prism560/TacLinkArm/sketches/fsr_servo/README.md

# fsr_servo
- 배선: FSR 분압(위쪽 Nano 5V) → A0, SG90 신호 → D9, 서보 전원 AA×4(약 6V), GND 공통
- 동작: `map(v, 20, 988, 0, 180)` + `constrain`, 3° 미만 변화는 무시(떨림 방지), 115200 baud
- 결과(2026-11-02): 누르는 정도에 따라 0→180° 연속 이동 — 분압 위쪽은 반드시 Nano 5V(6V에 연결하면 A0 과전압)
