prism560/TacLinkArm/notes/mcu_basics.md

# MCU 작동 원리 (클럭 · GPIO · ADC)

- 날짜: 2026-10-12 (S1 3주차)
- 보드: Arduino Nano (ATmega328P)

## 오늘 한 것
- Arduino 공식 문서 2개를 읽고 클럭·GPIO·ADC를 내 말로 정리했다.
  - [Digital Pins](https://docs.arduino.cc/learn/microcontrollers/digital-pins/)
  - [Analog Read Serial](https://docs.arduino.cc/tutorials/uno-rev3/AnalogReadSerial/)
  - 클럭 사양: [Arduino Nano](https://docs.arduino.cc/hardware/nano/) Tech Specs

## 클럭: 16MHz
Nano 보드에는 16MHz 클럭 소스가 있다. MCU는 1초에 1600만 번 뛰는 박자에 맞춰 동작하고, 대부분의 명령은 1~2박자 만에 처리된다. 한 박자는 62.5ns이다.
이 박자가 `millis()`·PWM·ADC 같은 모든 시간의 기준이므로, 코드 한 줄이 걸리는 시간과 센서를 1초에 몇 번 읽을 수 있는지(샘플링 속도)의 상한을 예측할 수 있다.

## GPIO: INPUT, OUTPUT, INPUT_PULLUP
GPIO는 general purpose input/output, 즉 범용 입출력을 뜻한다.
INPUT은 핀의 전압을 읽기만 하며, 아무것도 연결하지 않으면 HIGH와 LOW를 오간다. 이것을 플로팅이라 한다.
INPUT_PULLUP은 플로팅을 막기 위해 ATmega 내부 저항(20~50kΩ)으로 핀을 5V 쪽에 붙잡아 둔다. 그래서 스위치를 핀과 GND 사이에 연결하면 평소에는 HIGH, 누르면 LOW가 된다.
OUTPUT은 저임피던스 상태이다. ATmega 핀의 절대 최대 정격은 40mA이므로(실제로는 20mA 이하로 사용), 출력에 필요한 전류에 맞게 직렬 저항을 골라야 한다.

## ADC: 10비트, 0~1023
아두이노 안에는 ADC(Analog-to-Digital Converter)라는 회로가 있다. ADC는 0~5V의 전압을 0~1023(2^10 − 1)의 숫자로 바꾼다.
`analogRead()`는 핀 전압(0~5V)에 비례하는 값을 0~1023 사이의 `int`로 돌려준다. 예를 들어 2V를 읽으면 409를 돌려준다.
한 단계의 크기는 5V / 1024 ≈ 4.9mV이다.

## 아직 모르는 것
- 풀업으로 핀을 5V로 유지하는 원리를 회로이론에서 배운 것 같은데 기억이 잘 안 난다. 회로를 직접 그리고, 계산하고, 설명할 수 있으면 좋겠다.
- (코치 제안) 고임피던스·저임피던스가 정확히 무슨 뜻인지, 왜 입력은 고임피던스이고 출력은 저임피던스여야 하는지.

## Tinkercad 실습 (2026-10-13)
Arduino Uno로 회로 3개를 시뮬레이션했다. 코드는 직접 입력했다.
 
### 1) LED Blink
13번 → 220Ω 저항 → LED 애노드(+), LED 캐소드(−) → GND. `LED_BUILTIN`이 13번이라 보드 LED와 외부 LED가 함께 1초 간격으로 깜빡인다.

```cpp
void setup() {
  pinMode(LED_BUILTIN, OUTPUT);
}
 
void loop() {
  digitalWrite(LED_BUILTIN, HIGH);
  delay(1000);
  digitalWrite(LED_BUILTIN, LOW);
  delay(1000);
}
```
 
### 2) 버튼(INPUT_PULLUP) → LED
버튼을 11번과 GND 사이에 연결했다. 평소에는 내부 풀업 때문에 HIGH(1), 누르면 LOW(0)가 되고 그때 3번의 LED를 켠다. LED 직렬 저항은 캐소드 쪽에 두었다(직렬이면 위치는 상관없다).

```cpp
void setup() {
  Serial.begin(9600);
  pinMode(11, INPUT_PULLUP);
  pinMode(3, OUTPUT);
}
 
void loop() {
  int sensorVal = digitalRead(11);
  Serial.println(sensorVal);
 
  if (sensorVal == LOW) {
    digitalWrite(3, HIGH);
  } else {
    digitalWrite(3, LOW);
  }
  delay(100);
}
```
 
### 3) PWM 밝기 조절
같은 회로에서 `digitalWrite` 대신 `analogWrite`를 썼다. 3번은 PWM 핀(~)이다. 누르면 127(약 50%), 떼면 255(100%)로 밝기가 두 단계로 바뀐다.
 
```cpp
void setup() {
  Serial.begin(9600);
  pinMode(11, INPUT_PULLUP);
  pinMode(3, OUTPUT);
}
 
void loop() {
  int sensorVal = digitalRead(11);
  Serial.println(sensorVal);
 
  if (sensorVal == LOW) {
    analogWrite(3, 127);
  } else {
    analogWrite(3, 255);
  }
  delay(100);
}
```
 
### 실습에서 알게 된 것
- 버튼 입력에는 PWM 핀(11번)보다 2·4·7 같은 일반 핀을 쓰는 것이 좋다. PWM 핀은 출력용으로 아껴 둔다.
## PWM: analogWrite는 0~255
analogRead와 analogWrite는 서로 다른 하드웨어를 사용한다. 각각 10비트 ADC와 8비트 타이머 카운터를 사용한다. 추가로, analogWrite는 0V 또는 5V를 출력하는데 켜져 있는 시간의 비율(duty)만 달리 하여 단계를 조정한다. 이때 duty는 값/255, 평균 전압은 5V*값/255 계산한다.
 
정리하면, 해상도를 높이기 위해 단계를 늘려야 하는데 그러면 타이머 카운터의 비트수를 올려야하고, 그때 1초당 바퀴수가 줄어들며 주파수가 떨어진다. 
따라서 8비트 PWM 타이머 카운터는 해상도와 주파수 사이의 절충이다.

### 왜 8비트인가: 숫자로 (10-14)
- 타이머 카운터는 4µs마다 1씩 올라간다. 8비트면 0~255 한 바퀴가 256박자 = 1024µs ≈ 1ms이므로 1초에 약 1,000바퀴(약 1kHz)다. 10비트였다면 1024박자 ≈ 4ms, 1초에 약 250바퀴(약 250Hz)다.
- (교정) 4µs는 16MHz 클럭을 64로 나눈(분주) 값이다. Arduino가 64를 고른 이유는 Timer0이 `millis()`도 맡기 때문이다(한 바퀴 ≈ 1ms).
- (교정) 실제 주파수: 5·6번 약 980Hz, 3·9·10·11번 약 490Hz.

## 아직 모르는 것 (10-13 추가)
- 타이머 카운터의 비트 수를 늘리면 왜 PWM 주파수가 낮아지는지(해상도와 주파수의 트레이드오프). 코치에게 다시 설명을 듣기로 함. (10-14 해결)

## FSR 분압 (Tinkercad, 2026-10-19)
회로: 5V → FSR → A0 → 10kΩ → GND
- V(A0) = R / (R + FSR) × 5V. 누르면 FSR 저항이 내려가고 V(A0)가 올라간다.
- 풀업도 같은 분압이다: 위가 풀업 저항 R, 아래가 스위치 r. r = 0(누름)이면 0V, r = ∞(뗌)이면 5V.
- 측정: v 최소 0, 최대 466(약 2.28V). 시뮬의 FSR은 최대 힘에서도 약 12kΩ이라 1023까지 가지 않는다(코치 계산).
- 다음: 실물 FSR 402로 최소·최대를 다시 재고, `map()`의 입력 범위를 그 값으로 정한다. → 실물 결과는 [FSR→LED](fsr_led.md)
