prism560/TacLinkArm/docs/proposal.md

# TacLinkArm V1 기획서

> 상태: 목차와 요약 초안 (2026-10-05). 본문은 S1 12주차(12-14 \~ 12-20)에 완성한다.

## 1\. 배경·동기

연구 분야를 탐색하다가 촉각 데이터에 관심을 갖게 되었다. 사람이 생각하는 대로 로봇이 움직이고, 로봇이 느낀 것을 사람이 다시 느낄 수 있는 장치가 있다면 활용 범위가 매우 넓다고 판단했다.

## 2\. 목표와 성공 기준

* **목표**: 전완부 근전도(sEMG) 신호를 읽어 그리퍼를 움직이고, 그리퍼가 물체에 닿거나 물체를 잡았을 때 사용자의 손에 진동이 울리는 폐루프를 만든다.
* **성공 기준**: 완성도가 아니라 폐루프의 성립이다. "근육 신호 → 그리퍼 구동 → 파지 압력 감지 → 진동 피드백"이 처음부터 끝까지 끊김 없이 동작하면 성공이다.

## 3\. 시스템 구성 (3개 분야)

|분야|V1에서 하는 일|주요 부품|
|-|-|-|
|제어 입력|주먹 쥐기와 손 펴기 두 동작을 2채널 sEMG로 읽고, 근수축 세기에 비례하는 값으로 구분한다(RMS 엔벨로프·임계값 기반).|MyoWare 2.0 ×2|
|로봇팔·그리퍼|오픈소스 STL 기반의 전동식 2지(2-finger) 그리퍼를 출력·조립한다. 주먹을 쥐면 책상 위 물체를 안정적으로 잡고, 손을 펴면 놓는다. 압력(FSR)과 모터 전류(INA219)를 함께 보고 파지력을 조절한다.|서보, FSR 402, INA219|
|촉각 피드백|그리퍼가 감지한 파지 압력을 정해진 범위의 진동 세기로 바꿔 사용자의 손에 전달한다.|DRV2605L, LRA|

## 4\. V1 범위와 제외 항목

V1은 위 3개 분야의 최소 폐루프만 다룬다. 커스텀 PCB, 고전압 회로, 딥러닝 기반 신호 디코딩은 쓰지 않는다. 아래 항목은 의도적으로 V2·V3로 미룬다.

### V2

* 표면 근전도(sEMG) 및 햅틱 폐루프 XR 컨트롤러
* 다채널 플렉서블 인공 피부(E-Skin) 압력 센싱 및 로깅 모듈
* 블라인드 촉각 인식 기반 물체 물성 판별 그리퍼 (Project: Hand Without Eyes)
* 비전 기반 이미지/텍스트-촉각(Image/Text-to-Tactile) 신호 변환 및 햅틱 렌더러
* 초저지연 무선 텔레-햅틱(Tele-Haptics) 웨어러블 피드백 밴드
* 표면 근전도(sEMG) 기반 손목 제스처 무선 컨트롤러
* 다채널 sEMG 기반 연속 손동작 추정 및 로봇/드론 조작기
* 오디오/비디오 신호 기반 실시간 햅틱 렌더러 (X-to-Tactile Controller)

### V3

* 미디어파이프 손 포즈 연동 5자유도 섀도우 로봇 핸드 텔레오퍼레이션
* Tactile Property Determination Device
* 정전기 표면 마찰력(Electroadhesion) 변조 터치 패드
* 형상 변형(Shape-Changing) 및 2.5D 촉각 렌더링 디스플레이

### 장기 목표 (V2·V3 이후)

최종 목표는 다음 네 가지를 구축하는 것이다.

* 사람의 손가락 단위 움직임까지 감지하는 신경공학적 추적
* 사람의 손가락 움직임을 모방하는 로봇 손과 팔
* 사람의 촉각 인지를 모방한 로봇 그리퍼 센서
* 실제로 만지는 듯한 느낌을 전달하는 햅틱 장치 또는 신경공학적 방법론

## 5\. 시즌별 일정

V1은 15개월, 5개 시즌으로 진행한다.

|시즌|기간|목표|
|-|-|-|
|S1|1\~3개월차|연구 기획 및 이론·하드웨어 뼈대 구축|
|S2|4\~6개월차|제어 입력계통 및 구동부 구현|
|S3|7\~9개월차|센서 융합·적응형 파지력 제어 및 로봇 아키텍처 도입|
|S4|10\~12개월차|햅틱 폐루프 구현 및 AI 기반 신호처리 연동|
|S5|13\~15개월차|최적화, 시연 및 대학원용 포트폴리오 문서화|

S4의 AI 모델은 V1의 임계값 기반 제어와 비교하기 위한 벤치마크이며, V1 폐루프의 제어는 임계값·RMS 기반으로 유지한다.

## 6\. 부품·예산

* 부품 목록: [BoM.md](../BoM.md)
* 예산: V1 전체 시즌 합계 1,000만 원 이하

## 7\. 위험 요소와 대응

초안이며, 진행하면서 보완한다.

|위험 요소|대응|
|-|-|
|부품 배송 지연·초기 불량|납기가 긴 부품부터 주문하고, 핵심 부품은 예비 수량을 두며, 도착 즉시 검수한다.|
|sEMG 신호 품질(전극 위치, 땀, 움직임 잡음)|1채널부터 시작하고, 전극 위치를 기록하며, RMS 엔벨로프와 임계값을 사용자에 맞게 보정한다.|
|인체 부착 센서의 전기 안전|MyoWare는 배터리 등 절연된 전원으로 구동하고 안전 수칙을 먼저 확인한다.|
|서보 구동 시 전원 부족·잡음|서보 전원을 별도 배터리로 분리하고 접지를 공통으로 연결한다.|
|납땜·3D 프린팅 경험 부족|검증된 오픈소스 모듈과 STL을 조합하고, 학교 3D 프린팅 자원을 활용한다.|
|단독 개발에 따른 일정 지연|주당 작업량 상한과 완충 주를 두고, 폐루프와 무관한 항목부터 뒤로 미룬다.|

## 8\. 기록·공개 방식

* GitHub 저장소에 빌드로그를 공개한다(`notes/` 폴더, 진행 중).
* 추후 블로그와 포트폴리오 사이트를 구축한다.
