prism560/TacLinkArm/docs/img/2026-11-04/KakaoTalk_20261104_235307183_01.jpg

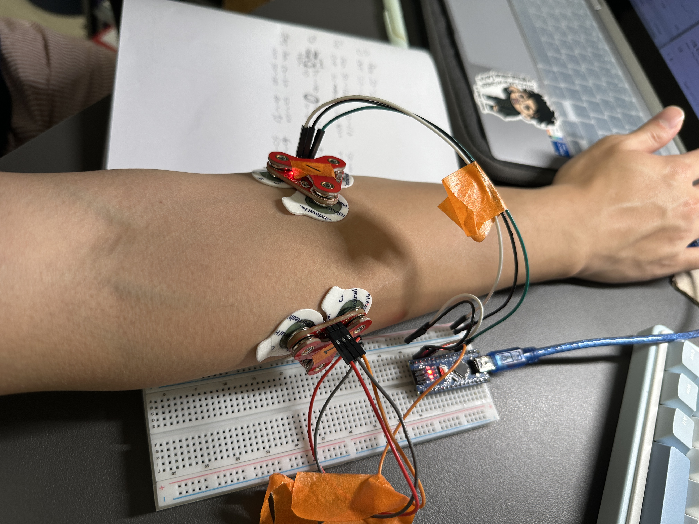
docs/img/2026-11-04/KakaoTalk_20261104_235307183_01.jpg
