prism560/TacLinkArm/docs/img/2026-11-04/스크린샷 2026-11-04 233234.png

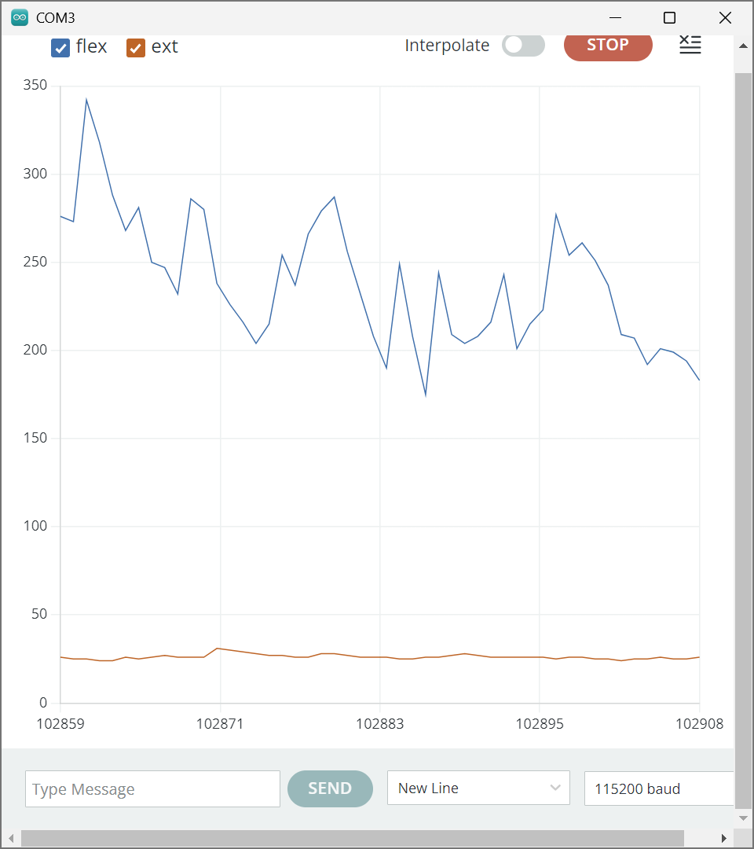
docs/img/2026-11-04/스크린샷 2026-11-04 233234.png
