prism560/TacLinkArm/notes/soldering.md

# 첫 핀 헤더 납땜 (2026-10-21)
검사: 육안 브리지 확인 + 암 점퍼를 끝까지 꽂았을 때 체결되는 핀 수(n/m)

| 순서 | 보드 | 핀 | 브리지 | 체결 n/m | 메모 |
|---|---|---|---|---|---|
| 1 | Pro Mini (연습) | DTR~GND | 없음 | 2/6 | |
| 2 | MyoWare (1) | VIN·GND·ENV | 없음 | 1/3 | 실패 2개 중 1개는 꽂히나 약함 |
| 3 | MyoWare (2) | VIN·GND·ENV | 없음 | 0/3 | 실패 3개 중 2개는 꽂히나 약함 |
| 4 | DRV2605L | VIN~INT | 없음 | 5/5 | 땜납을 적게, 빠르게 녹이면 예쁘게 잘 된다 |
| 5 | INA219 | Vcc~Vin+ | 없음 | 2/6 | 실패 4개 모두 꽂히나 약함 |

## 느낀 점
- 처음이라 실패가 많았다. 초보에게는 어렵지만 숙련되면 간단한 작업이라고 느꼈다.
- 납 제거기가 필요하다.
- 작업 환경: 인두기 선이 짧아 방바닥에서 작업했고, 선 정리 중 인두 끝에 고무가 조금 녹았다(바로 조치). 책상에 작업 매트를 깔고 인두기를 올려 둘 환경이 필요하다.

## 납땜 원리 (코치 설명)
- 납땜은 접착이 아니라 금속 결합이다. 녹은 땜납이 구리 패드와 핀 표면에 '젖어' 얇은 합금층을 만든다. 플럭스는 이 젖음을 막는 산화막을 없앤다.
- 유연납 Sn63/Pb37은 공정(eutectic) 조성이라 183°C 한 온도에서 녹고 굳는다 → 빨리 녹고 빨리 굳는다. 굳는 동안 움직이면 냉납이 된다.
- 도체인 것은 필요조건일 뿐이고, 쓰는 이유는 낮은 녹는점 + 구리에 잘 젖음 + 굳으면 기계적으로도 고정됨.
- 구멍(스루홀)은 빈틈없이 채울 필요는 없다. 핀과 패드가 모두 젖어 오목한 원뿔(화산) 모양이면 좋은 접합이다.
- 순서: 인두로 패드와 핀을 함께 1~2초 데움 → 땜납은 인두가 아니라 접합부에 댐 → 땜납 떼고 → 인두 뗌. 한 핀에 3~5초 안팎.
- 체결 실패 원인(확인): 헤더의 긴 쪽을 구멍에 넣고 납땜했다. 헤더는 짧은 쪽(약 3mm)을 구멍에 넣어 납땜하고, 긴 쪽(약 6mm)에 점퍼나 브레드보드를 꽂는다. 그래서 점퍼가 짧은 쪽에서는 끝까지 안 들어갔고, 긴 쪽에서는 타고 올라간 땜납에 걸렸다.
- 다시 하기: 헤더 플라스틱을 니퍼로 잘라 핀을 하나씩 뽑고(솔더윅), 구멍을 비운 뒤 새 헤더를 바른 방향으로 납땜.

## 재작업 기록
기준: 헤더는 짧은 쪽(약 3mm)을 구멍에 넣고, 플라스틱·긴 핀이 나오는 면을 **먼저** 정한 뒤 납땜한다. 검사는 멀티미터 통전(n/m) + 육안 브리지.

| 보드 | 처음 실수 | 올바른 방향 (플라스틱·긴 핀 면 / 납땜 면) | 재작업 날짜 | 결과 |
|---|---|---|---|---|
| MyoWare (2) | 10-21 긴 쪽을 구멍에 넣음 → 체결 0/3 | 긴 핀·플라스틱 = 스냅 반대면 / 스냅 면에서 납땜, 스냅 면 핀 끝 절단 | 10-29 | 3/3 통전, 브리지·손상 없음 |
| MyoWare (1) | 10-21 긴 쪽을 구멍에 넣음 → 1/3. 10-28 1차 재작업은 납땜은 정상이지만 헤더가 스냅(전극) 면으로 나와 피부에 닿음 | 긴 핀·플라스틱 = 스냅 반대면 / 스냅 면에서 납땜, 스냅 면 핀 끝 절단 | 11-03 (2차) | 3/3 통전, 브리지 없음 |
| INA219 | 10-21 긴 쪽을 구멍에 넣음 → 2/6 | 칩·나사 단자 면이 위, 긴 핀·플라스틱 = 아랫면(브레드보드 쪽) / 칩 면에서 납땜, 브레드보드에 꽂은 채 작업 | 11-03 | 6/6 통전, 브리지 없음 |

### 재작업에서 배운 점
- 핀 제거: 플라스틱을 니퍼로 자르고, 한 칸씩 땜납을 녹이면서 핀을 하나씩 뽑았다(솔더윅으로 구멍 비우기). 보드 하나에 1시간 가까이 걸렸다.
- '짧은 쪽을 구멍에'만으로는 부족하다. 부품이 나중에 어떻게 쓰이는지(MyoWare는 아랫면 스냅에 전극을 붙여 팔에 올리고, INA219는 브레드보드에 꽂음)를 보고 긴 핀이 나올 면을 먼저 정해야 한다.
- 연기가 생각보다 많다. 마스크를 쓰고 선풍기로 연기를 옆으로 보내며, 20~30분마다 쉰다.
- 이후: MyoWare (1)(2) 모두 11-04 2채널 동시 측정에 정상 사용.
