prism560/TacLinkArm/(commit log)

2026-11-11 Add .gitignore for media and local settings
    영상(mp4·mov·avi), Claude Code 개인 설정, OS 파일 제외
2026-11-11 Add Claude Code project settings and upload command
    CLAUDE.md 작업 규칙, 권한 설정(settings.json), /upload 명령
